tonnerre33/Soil_Moisture_Sensor_Pro_Mini/Soil_Moisture_Sensor_Pro_Mini-top.png

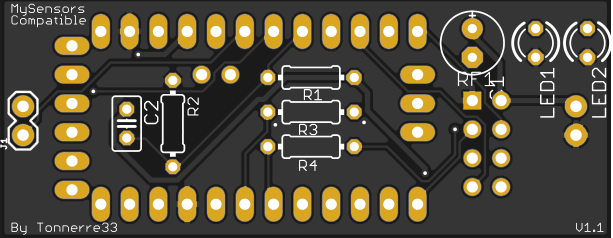
Soil_Moisture_Sensor_Pro_Mini-top.png
