tonnerre33/Soil_Moisture_Sensor_Pro_Mini/Soil_Moisture_Sensor_Pro_Mini.png

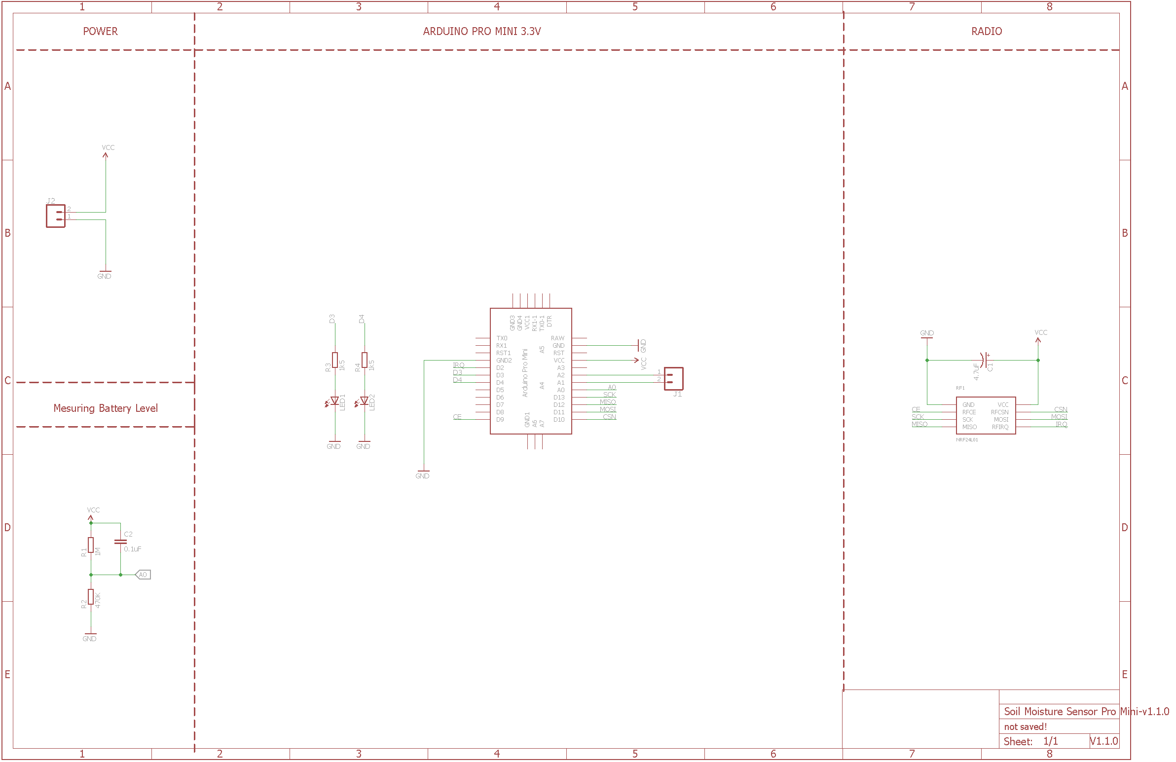
Soil_Moisture_Sensor_Pro_Mini.png
