tonnerre33/Soil_Moisture_Sensor_Pro_Mini/Soil_Moisture_Sensor_Pro_Mini.pdf

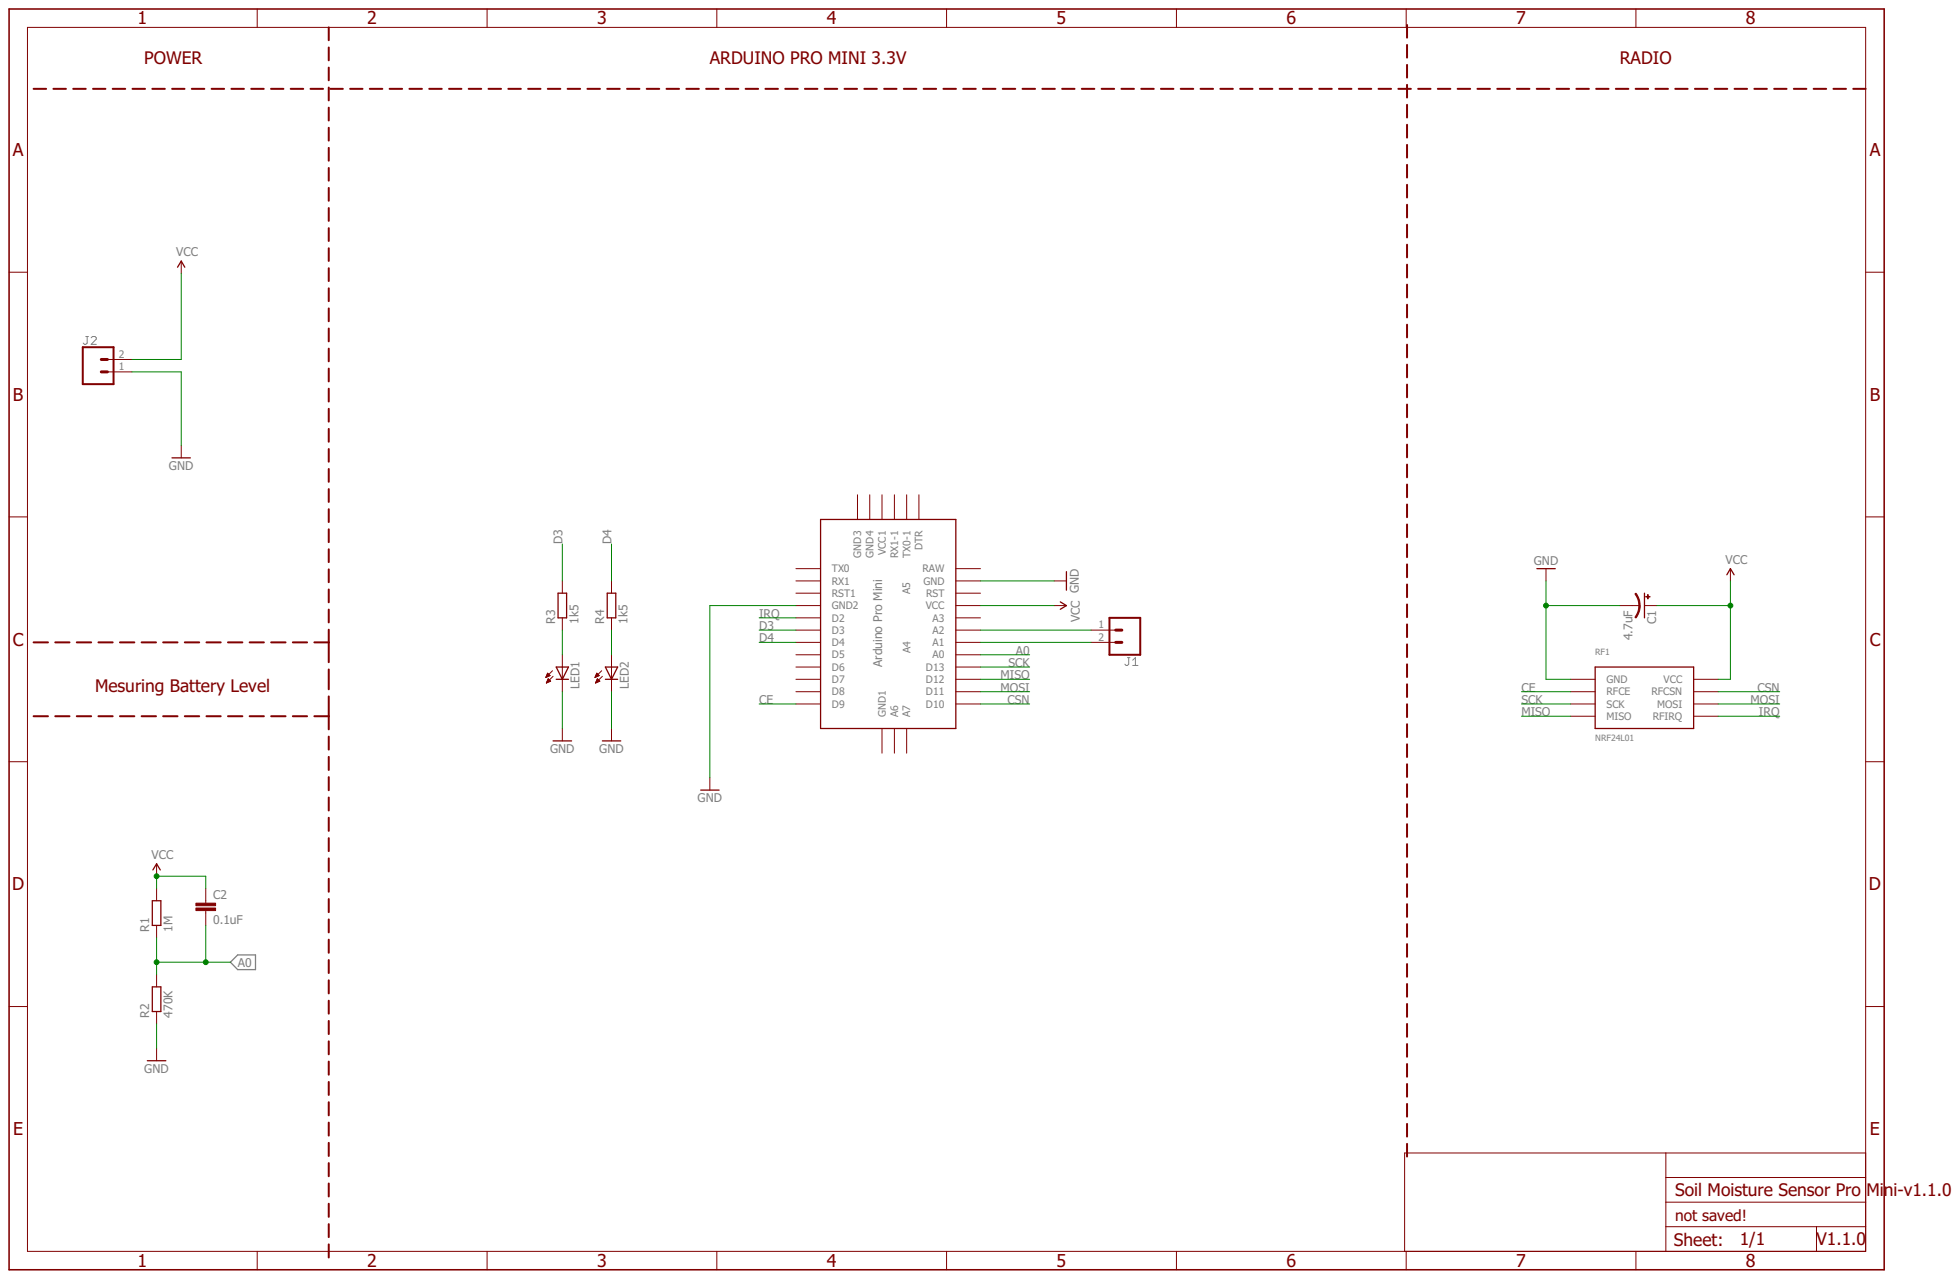
[picture p4: page 1]
