tonnerre33/Soil_Moisture_Sensor_Pro_Mini/Soil_Moisture_Sensor_Pro_Mini.brd

## EAGLE design Soil_Moisture_Sensor_Pro_Mini.brd (2017-03-18)

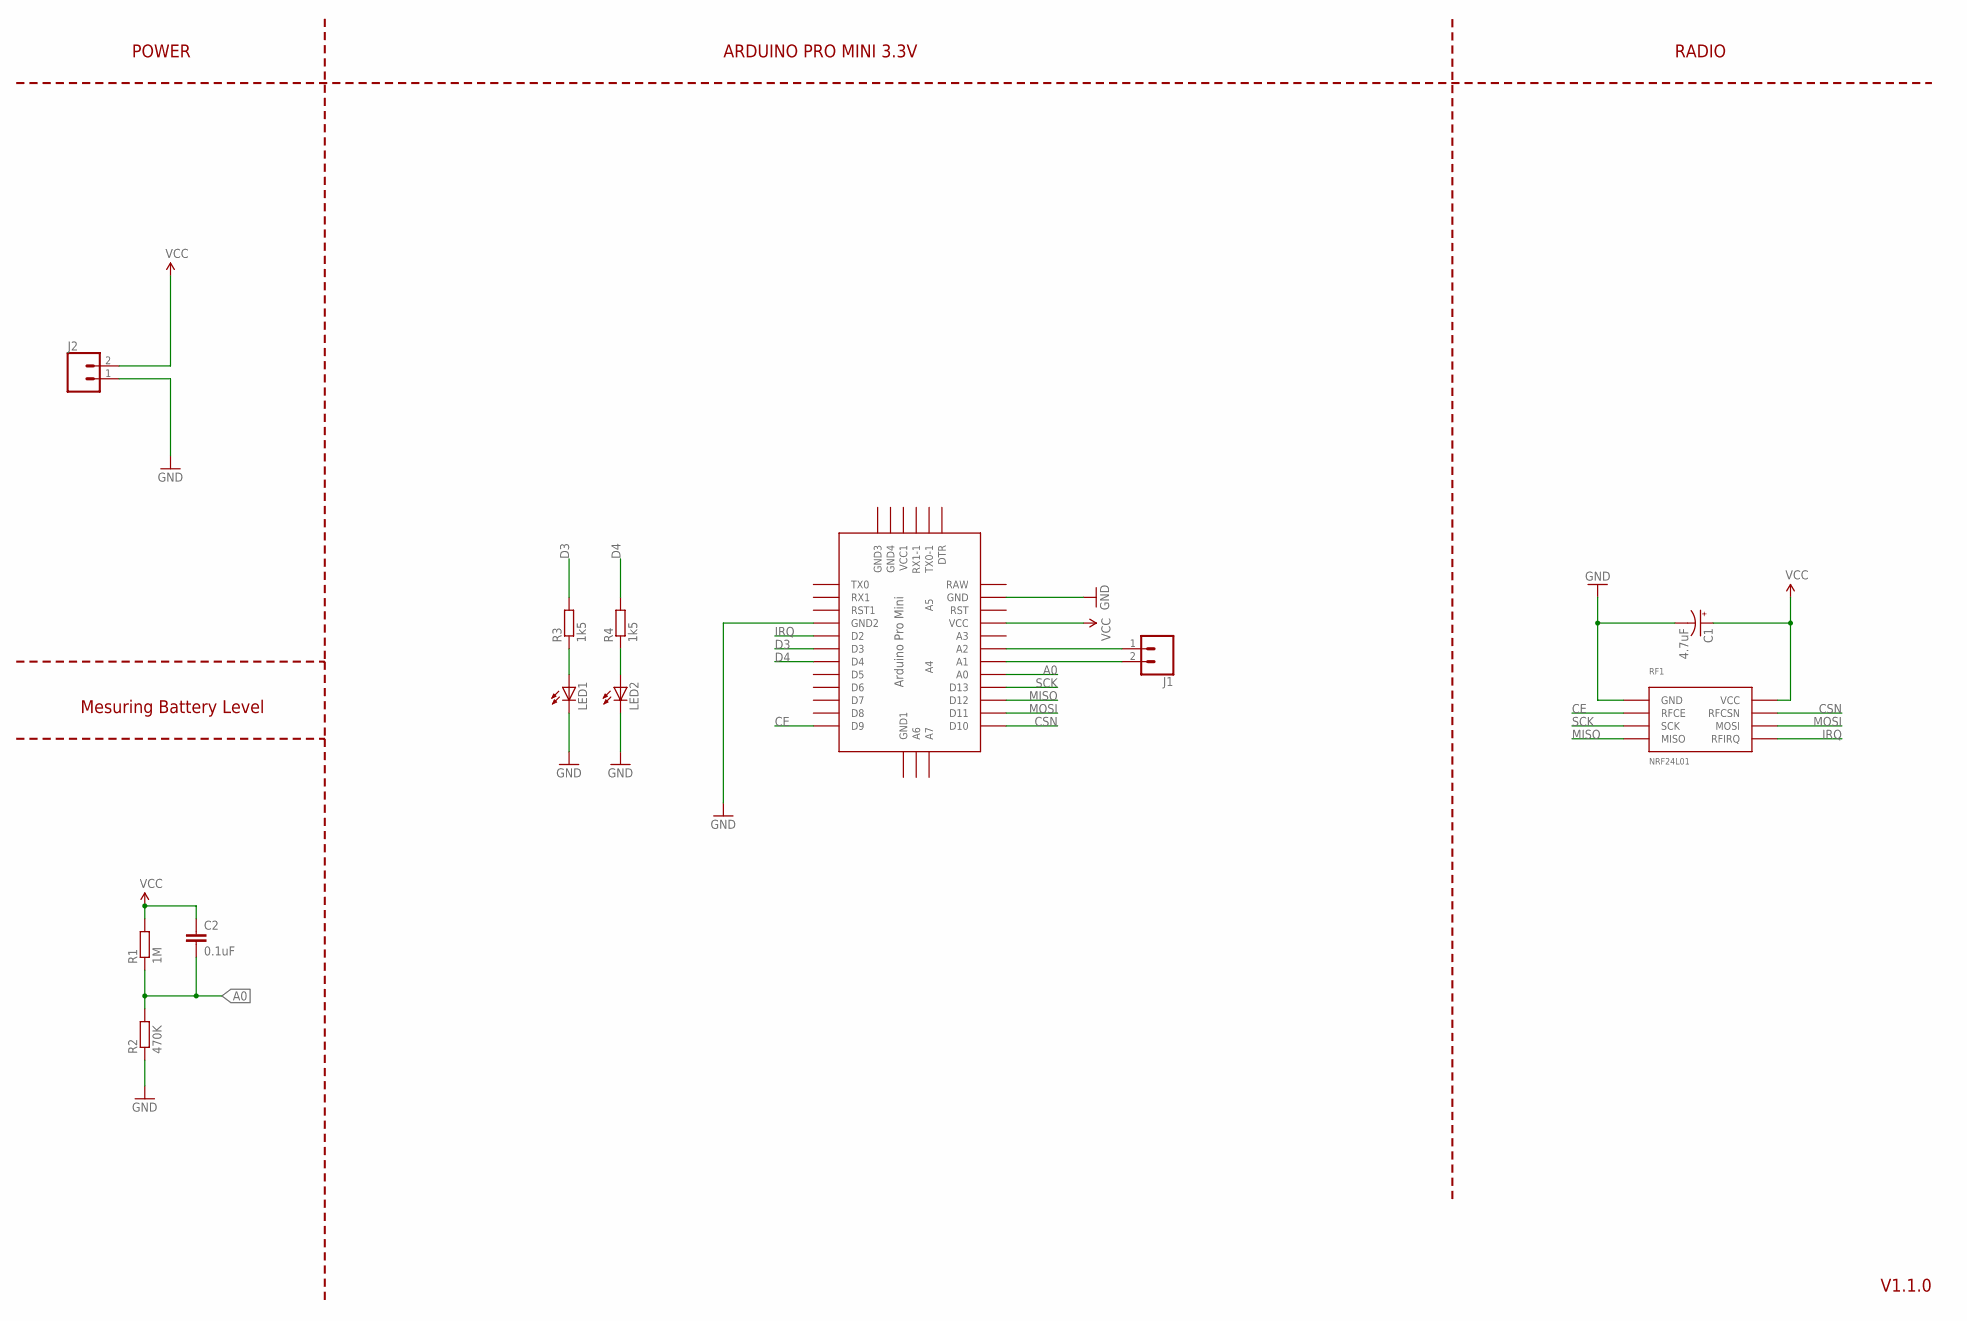
[picture p5: schematic Soil_Moisture_Sensor_Pro_Mini.sch]

Parts:
C1: 4.7uF; E2,5-6E
C2: 0.1uF; C025-025X050
J1, J2: CONN_02; 1X02
LED1, LED2: LED3MM
R1: 1M; 0204/7
R2: 470K; 0204/7
R3, R4: 1k5; 0204/7
RF1: NRF24L01; 2X4-2.54MM
U$1: ABK-PRO-MINI

Connections:
A0: C2.2, R1.1, R2.2, U$1.A0
CE: RF1.P$3 (RFCE), U$1.D9
CSN: RF1.P$4 (RFCSN), U$1.D10
D3: R3.2, U$1.D3
D4: R4.2, U$1.D4
GND: C1.-, J2.1, LED1.K (C), LED2.K (C), R2.1, RF1.P$1 (GND), U$1.GND, U$1.GND1 (GND2)
IRQ: RF1.P$8 (RFIRQ), U$1.D2
MISO: RF1.P$7 (MISO), U$1.D12
MOSI: RF1.P$6 (MOSI), U$1.D11
unnamed: J1.1, U$1.A2
unnamed: J1.2, U$1.A1
unnamed: LED2.A, R4.1
unnamed: LED1.A, R3.1
SCK: RF1.P$5 (SCK), U$1.D13
VCC: C1.+, C2.1, J2.2, R1.2, RF1.P$2 (VCC), U$1.VCC

Notes on the sheet:
POWER
ARDUINO PRO MINI 3.3V
RADIO
Mesuring Battery Level
V1.1.0

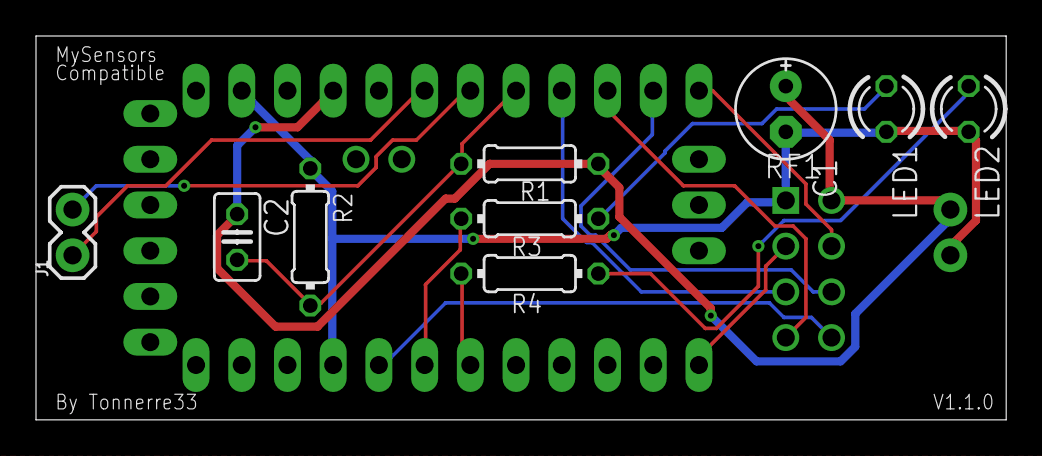
[picture p6: board Soil_Moisture_Sensor_Pro_Mini.brd from above]

Board: 2 copper layers, 53.9 x 21.3 mm, 12 parts (1 on the bottom side), 15 nets.
