tonnerre33/Soil_Moisture_Sensor_Pro_Mini/(notices)

Notices in the files:
Soil_Moisture_Sensor_Pro_Mini.ino:
modify it under the terms of the GNU General Public License
parts and their libraries:
SparkFun-Connectors: Licensing: Creative Commons ShareAlike 4.0 International - https://creativecommons.org/licenses/by-sa/4.0
